akuker/RASCSI-68kmlaver/README.md

# RASCSI-68kmlaver
A scsi emulator based off of the work of http://www.geocities.jp/kugimoto0715/rascsi/index.html

# ATTENTION:
This repository is being archived. The current working version of the board has been moved to:
https://github.com/akuker/RASCSI/tree/master/hw/Dual_Connector_RaSCSI
