akuker/RASCSI-68kmlaver/design files/rpi_adapter/rpi_adapter/rpi_adapter.kicad_pcb

## KiCad design design files/rpi_adapter/rpi_adapter/rpi_adapter.kicad_pcb (2020-06-28)

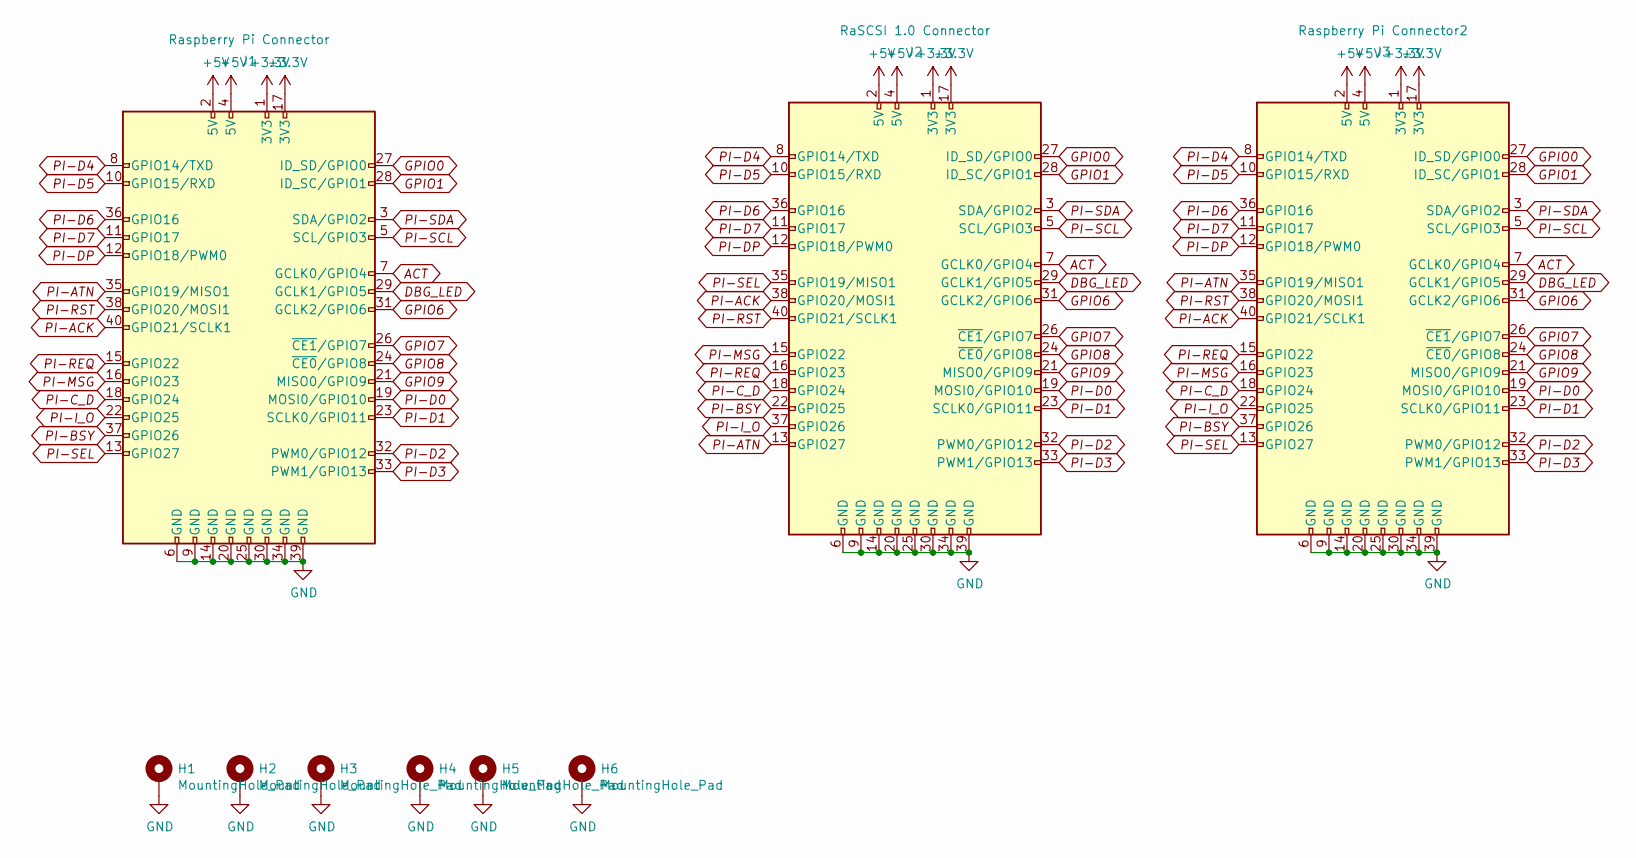
[picture p1: schematic rpi_adapter.sch]

Parts:
H1, H2, H3, H4, H5, H6: MountingHole_Pad; MountingHole_2.7mm_M2.5_Pad_Via
J1: Raspberry Pi Connector; PinHeader_2x20_P2.54mm_Vertical
J2: RaSCSI 1.0 Connector; PinHeader_2x20_P2.54mm_Vertical
J3: Raspberry Pi Connector2; PinHeader_2x20_P2.54mm_Vertical

Connections:
+3V3: J1.1 (3V3), J1.17 (3V3), J2.1 (3V3), J2.17 (3V3), J3.1 (3V3), J3.17 (3V3)
+5V: J1.2 (5V), J1.4 (5V), J2.2 (5V), J2.4 (5V), J3.2 (5V), J3.4 (5V)
ACT: J1.7 (GCLK0/GPIO4), J2.7 (GCLK0/GPIO4), J3.7 (GCLK0/GPIO4)
DBG_LED: J1.29 (GCLK1/GPIO5), J2.29 (GCLK1/GPIO5), J3.29 (GCLK1/GPIO5)
GND: H1.1, H2.1, H3.1, H4.1, H5.1, H6.1, J1.6 (GND), J1.9 (GND), J1.14 (GND), J1.20 (GND), J1.25 (GND), J1.30 (GND), J1.34 (GND), J1.39 (GND), J2.6 (GND), J2.9 (GND), J2.14 (GND), J2.20 (GND), J2.25 (GND), J2.30 (GND), J2.34 (GND), J2.39 (GND), J3.6 (GND), J3.9 (GND), J3.14 (GND), J3.20 (GND), J3.25 (GND), J3.30 (GND), J3.34 (GND), J3.39 (GND)
GPIO0: J1.27 (ID_SD/GPIO0), J2.27 (ID_SD/GPIO0), J3.27 (ID_SD/GPIO0)
GPIO1: J1.28 (ID_SC/GPIO1), J2.28 (ID_SC/GPIO1), J3.28 (ID_SC/GPIO1)
GPIO6: J1.31 (GCLK2/GPIO6), J2.31 (GCLK2/GPIO6), J3.31 (GCLK2/GPIO6)
GPIO7: J1.26 (~CE1~/GPIO7), J2.26 (~CE1~/GPIO7), J3.26 (~CE1~/GPIO7)
GPIO8: J1.24 (~CE0~/GPIO8), J2.24 (~CE0~/GPIO8), J3.24 (~CE0~/GPIO8)
GPIO9: J1.21 (MISO0/GPIO9), J2.21 (MISO0/GPIO9), J3.21 (MISO0/GPIO9)
PI-ACK: J1.40 (GPIO21/SCLK1), J2.38 (GPIO20/MOSI1), J3.40 (GPIO21/SCLK1)
PI-ATN: J1.35 (GPIO19/MISO1), J2.13 (GPIO27), J3.35 (GPIO19/MISO1)
PI-BSY: J1.37 (GPIO26), J2.22 (GPIO25), J3.37 (GPIO26)
PI-C_D: J1.18 (GPIO24), J2.18 (GPIO24), J3.18 (GPIO24)
PI-D0: J1.19 (MOSI0/GPIO10), J2.19 (MOSI0/GPIO10), J3.19 (MOSI0/GPIO10)
PI-D1: J1.23 (SCLK0/GPIO11), J2.23 (SCLK0/GPIO11), J3.23 (SCLK0/GPIO11)
PI-D2: J1.32 (PWM0/GPIO12), J2.32 (PWM0/GPIO12), J3.32 (PWM0/GPIO12)
PI-D3: J1.33 (PWM1/GPIO13), J2.33 (PWM1/GPIO13), J3.33 (PWM1/GPIO13)
PI-D4: J1.8 (GPIO14/TXD), J2.8 (GPIO14/TXD), J3.8 (GPIO14/TXD)
PI-D5: J1.10 (GPIO15/RXD), J2.10 (GPIO15/RXD), J3.10 (GPIO15/RXD)
PI-D6: J1.36 (GPIO16), J2.36 (GPIO16), J3.36 (GPIO16)
PI-D7: J1.11 (GPIO17), J2.11 (GPIO17), J3.11 (GPIO17)
PI-DP: J1.12 (GPIO18/PWM0), J2.12 (GPIO18/PWM0), J3.12 (GPIO18/PWM0)
PI-I_O: J1.22 (GPIO25), J2.37 (GPIO26), J3.22 (GPIO25)
PI-MSG: J1.16 (GPIO23), J2.15 (GPIO22), J3.16 (GPIO23)
PI-REQ: J1.15 (GPIO22), J2.16 (GPIO23), J3.15 (GPIO22)
PI-RST: J1.38 (GPIO20/MOSI1), J2.40 (GPIO21/SCLK1), J3.38 (GPIO20/MOSI1)
PI-SCL: J1.5 (SCL/GPIO3), J2.5 (SCL/GPIO3), J3.5 (SCL/GPIO3)
PI-SDA: J1.3 (SDA/GPIO2), J2.3 (SDA/GPIO2), J3.3 (SDA/GPIO2)
PI-SEL: J1.13 (GPIO27), J2.35 (GPIO19/MISO1), J3.13 (GPIO27)

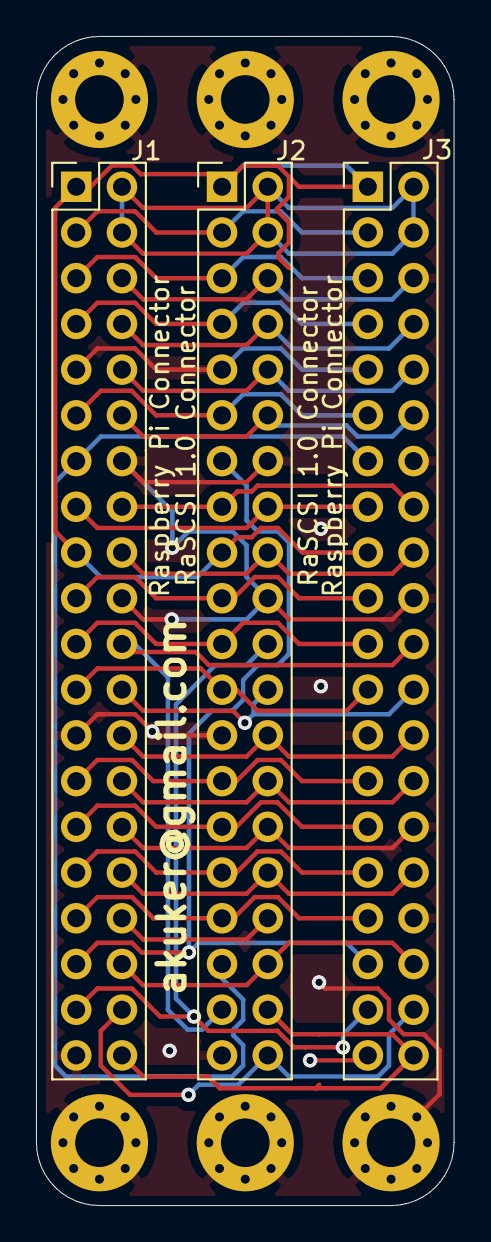
[picture p2: board rpi_adapter.kicad_pcb from above]

Board: 2 copper layers, 23.2 x 65.0 mm, 9 parts (0 on the bottom side), 31 nets.
