akuker/RASCSI-68kmlaver/design files/Dual Connector Ver/rascsi_din.kicad_pcb

## KiCad design design files/Dual Connector Ver/rascsi_din.kicad_pcb (2020-07-08)

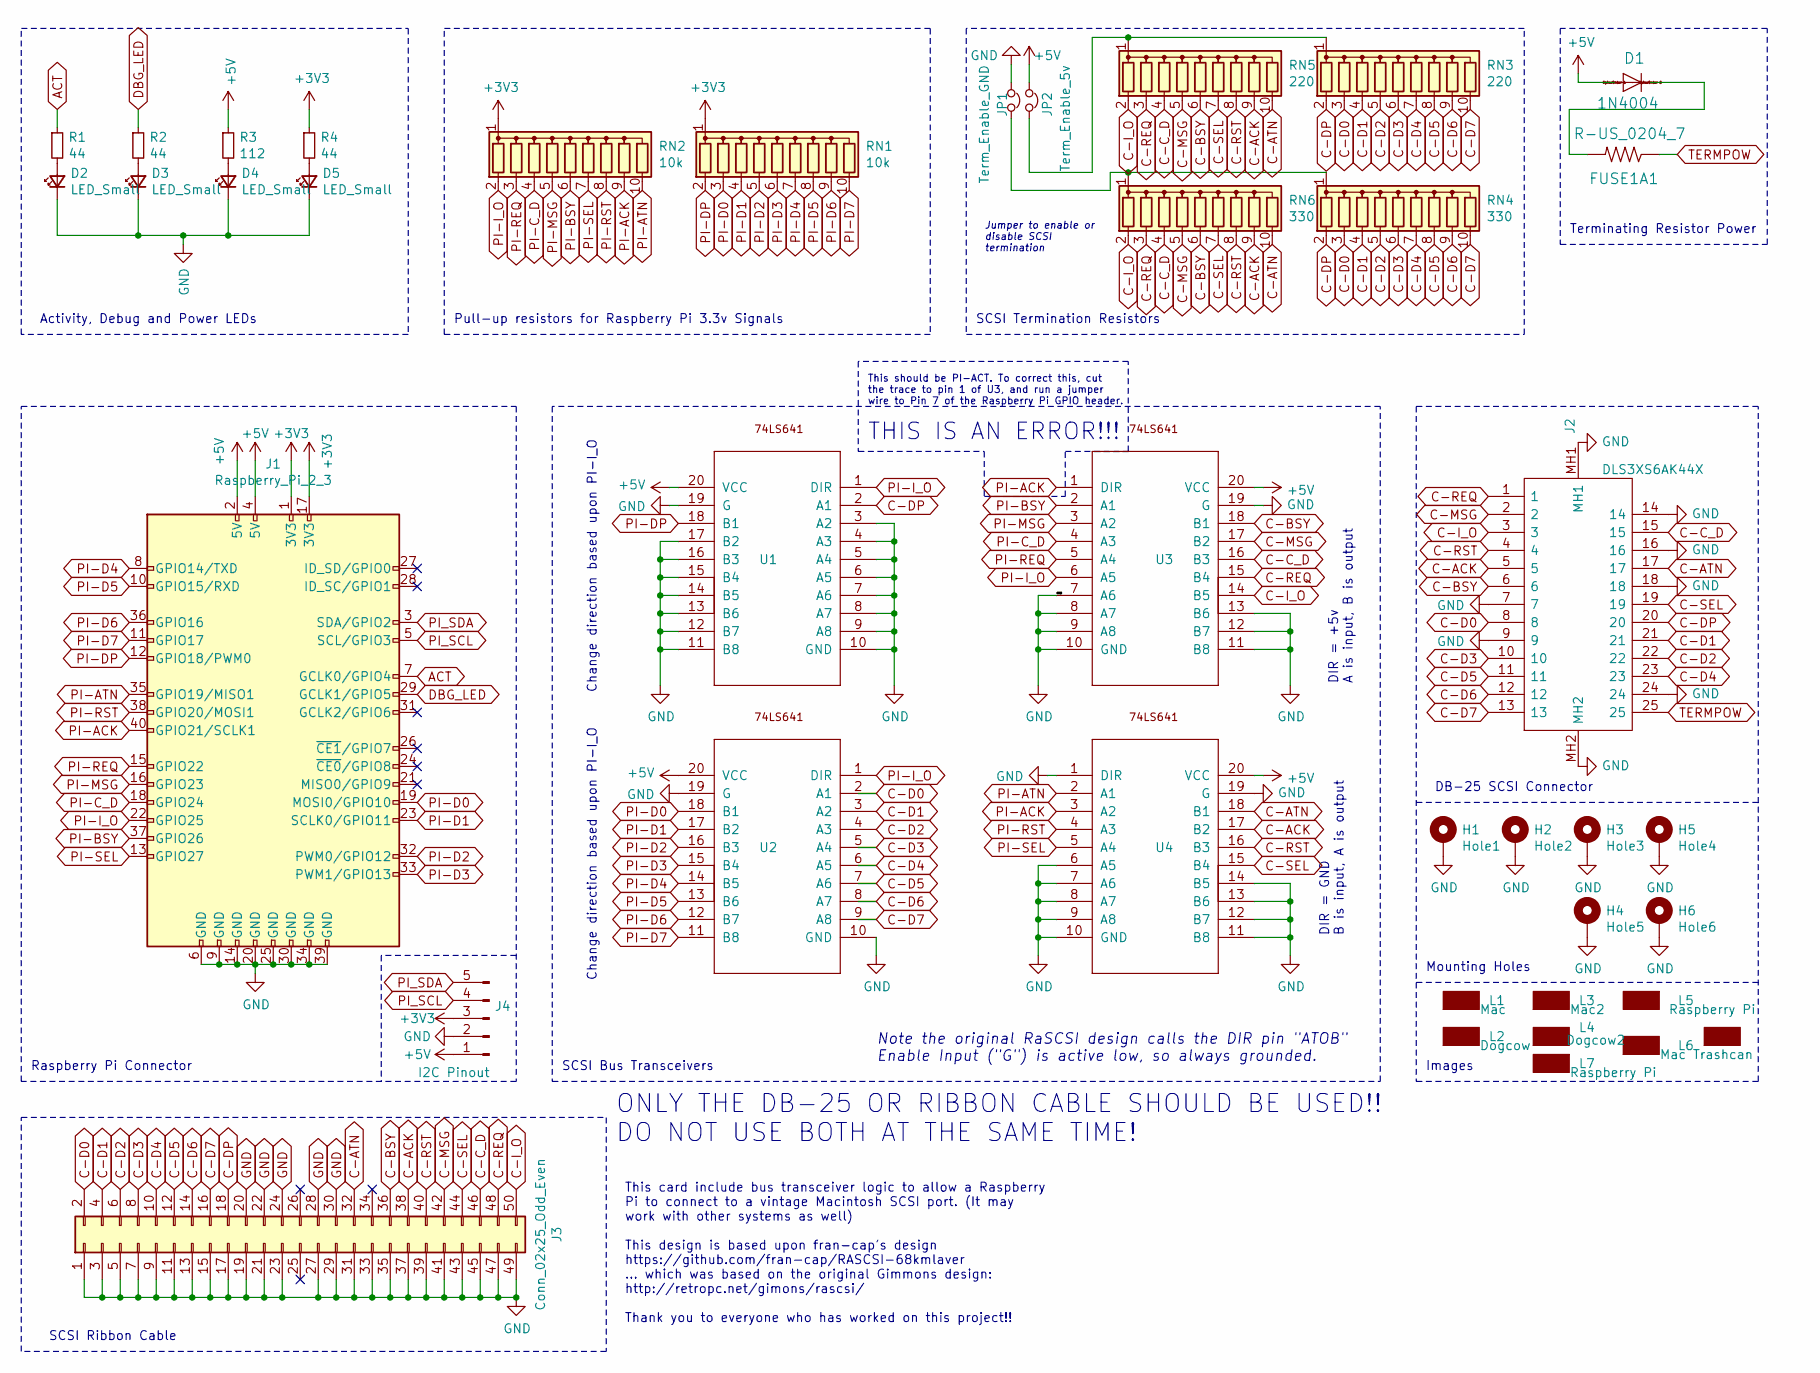
[picture p3: schematic rascsi_din.sch]

Parts:
D1: 1N4004; DO41-10
D2, D3, D4, D5: LED_Small; LED_0805_2012Metric
FUSE1A1: R-US_0204_7; 0204_7
H1: Hole1; MountingHole_2.7mm_M2.5_Pad_Via
H2: Hole2; MountingHole_2.7mm_M2.5_Pad_Via
H3: Hole3; MountingHole_2.7mm_M2.5_Pad_Via
H4: Hole5; MountingHole_2.7mm_M2.5_Pad_Via
H5: Hole4; MountingHole_2.7mm_M2.5_Pad_Via
H6: Hole6; MountingHole_2.7mm_M2.5_Pad_Via
J1: Raspberry_Pi_2_3; PinSocket_2x20_P2.54mm_Vertical
J2: DLS3XS6AK44X; Mouser Part Number 706-DLS3XS6AK44X
J3: Conn_02x25_Odd_Even; PinHeader_2x25_P2.54mm_Vertical_SMD
J4: I2C Pinout; PinSocket_1x05_P2.54mm_Vertical
JP1: Term_Enable_GND; PinSocket_1x02_P2.54mm_Vertical
JP2: Term_Enable_5v; PinSocket_1x02_P2.54mm_Vertical
L1: Mac; mac_happy_small
L2: Dogcow; dogcow
L3: Mac2; mac_happy_small
L4: Dogcow2; dogcow
L5, L7: Raspberry Pi; pi_logo
L6: Mac Trashcan; mac_trashcan
R1, R2, R4: 44; R_0805_2012Metric
R3: 112; R_0805_2012Metric
RN1, RN2: 10k; R_Array_SIP10
RN3, RN5: 220; R_Array_SIP10
RN4, RN6: 330; R_Array_SIP10
U1, U2, U3, U4: SN74LS641-1C; SOIC20S
U$1: LOGO

Connections:
+3V3: J1.1 (3V3), J1.17 (3V3), J4.3, R4.1, RN1.1 (common), RN2.1 (common)
+5V: D1.A, J1.2 (5V), J1.4 (5V), J4.1, JP2.1, R3.1, U1.20 (VCC), U2.20 (VCC), U3.20 (VCC), U4.20 (VCC)
ACT: J1.7 (GCLK0/GPIO4), R1.1
C-ACK: J2.5, J3.38, RN5.9 (R8), RN6.9 (R8), U4.17 (B2)
C-ATN: J2.17, J3.32, RN5.10 (R9), RN6.10 (R9), U4.18 (B1)
C-BSY: J2.6, J3.36, RN5.6 (R5), RN6.6 (R5), U3.18 (B1)
C-C_D: J2.15, J3.46, RN5.4 (R3), RN6.4 (R3), U3.16 (B3)
C-D0: J2.8, J3.2, RN3.3 (R2), RN4.3 (R2), U2.2 (A1)
C-D1: J2.21, J3.4, RN3.4 (R3), RN4.4 (R3), U2.3 (A2)
C-D2: J2.22, J3.6, RN3.5 (R4), RN4.5 (R4), U2.4 (A3)
C-D3: J2.10, J3.8, RN3.6 (R5), RN4.6 (R5), U2.5 (A4)
C-D4: J2.23, J3.10, RN3.7 (R6), RN4.7 (R6), U2.6 (A5)
C-D5: J2.11, J3.12, RN3.8 (R7), RN4.8 (R7), U2.7 (A6)
C-D6: J2.12, J3.14, RN3.9 (R8), RN4.9 (R8), U2.8 (A7)
C-D7: J2.13, J3.16, RN3.10 (R9), RN4.10 (R9), U2.9 (A8)
C-DP: J2.20, J3.18, RN3.2 (R1), RN4.2 (R1), U1.2 (A1)
C-I_O: J2.3, J3.50, RN5.2 (R1), RN6.2 (R1), U3.14 (B5)
C-MSG: J2.2, J3.42, RN5.5 (R4), RN6.5 (R4), U3.17 (B2)
C-REQ: J2.1, J3.48, RN5.3 (R2), RN6.3 (R2), U3.15 (B4)
C-RST: J2.4, J3.40, RN5.8 (R7), RN6.8 (R7), U4.16 (B3)
C-SEL: J2.19, J3.44, RN5.7 (R6), RN6.7 (R6), U4.15 (B4)
DBG_LED: J1.29 (GCLK1/GPIO5), R2.1
GND: D2.1 (K), D3.1 (K), D4.1 (K), D5.1 (K), H1.1, H2.1, H3.1, H4.1, H5.1, H6.1, J1.6 (GND), J1.9 (GND), J1.14 (GND), J1.20 (GND), J1.25 (GND), J1.30 (GND), J1.34 (GND), J1.39 (GND), J2.7, J2.9, J2.14, J2.16, J2.18, J2.24, J2.MH1, J2.MH2, J3.1, J3.3, J3.5, J3.7, J3.9, J3.11, J3.13, J3.15, J3.17, J3.19, J3.20, J3.21, J3.22, J3.23, J3.24, J3.27, J3.28, J3.29, J3.30, J3.31, J3.33, J3.35, J3.37, J3.39, J3.41, J3.43, J3.45, J3.47, J3.49, J4.2, JP1.1, U1.3 (A2), U1.4 (A3), U1.5 (A4), U1.6 (A5), U1.7 (A6), U1.8 (A7), U1.9 (A8), U1.10 (GND), U1.11 (B8), U1.12 (B7), U1.13 (B6), U1.14 (B5), U1.15 (B4), U1.16 (B3), U1.17 (B2), U1.19 (G), U2.10 (GND), U2.19 (G), U3.7 (A6), U3.8 (A7), U3.9 (A8), U3.10 (GND), U3.11 (B8), U3.12 (B7), U3.13 (B6), U3.19 (G), U4.1 (DIR), U4.6 (A5), U4.7 (A6), U4.8 (A7), U4.9 (A8), U4.10 (GND), U4.11 (B8), U4.12 (B7), U4.13 (B6), U4.14 (B5), U4.19 (G)
unnamed: D1.C, FUSE1A1.2
unnamed: D2.2 (A), R1.2
unnamed: D3.2 (A), R2.2
unnamed: D4.2 (A), R3.2
unnamed: D5.2 (A), R4.2
unnamed: JP1.2, RN4.1 (common), RN6.1 (common)
unnamed: JP2.2, RN3.1 (common), RN5.1 (common)
PI-ACK: J1.40 (GPIO21/SCLK1), RN2.9 (R8), U3.1 (DIR), U4.3 (A2)
PI-ATN: J1.35 (GPIO19/MISO1), RN2.10 (R9), U4.2 (A1)
PI-BSY: J1.37 (GPIO26), RN2.6 (R5), U3.2 (A1)
PI-C_D: J1.18 (GPIO24), RN2.4 (R3), U3.4 (A3)
PI-D0: J1.19 (MOSI0/GPIO10), RN1.3 (R2), U2.18 (B1)
PI-D1: J1.23 (SCLK0/GPIO11), RN1.4 (R3), U2.17 (B2)
PI-D2: J1.32 (PWM0/GPIO12), RN1.5 (R4), U2.16 (B3)
PI-D3: J1.33 (PWM1/GPIO13), RN1.6 (R5), U2.15 (B4)
PI-D4: J1.8 (GPIO14/TXD), RN1.7 (R6), U2.14 (B5)
PI-D5: J1.10 (GPIO15/RXD), RN1.8 (R7), U2.13 (B6)
PI-D6: J1.36 (GPIO16), RN1.9 (R8), U2.12 (B7)
PI-D7: J1.11 (GPIO17), RN1.10 (R9), U2.11 (B8)
PI-DP: J1.12 (GPIO18/PWM0), RN1.2 (R1), U1.18 (B1)
PI-I_O: J1.22 (GPIO25), RN2.2 (R1), U1.1 (DIR), U2.1 (DIR), U3.6 (A5)
PI-MSG: J1.16 (GPIO23), RN2.5 (R4), U3.3 (A2)
PI-REQ: J1.15 (GPIO22), RN2.3 (R2), U3.5 (A4)
PI-RST: J1.38 (GPIO20/MOSI1), RN2.8 (R7), U4.4 (A3)
PI-SEL: J1.13 (GPIO27), RN2.7 (R6), U4.5 (A4)
PI_SCL: J1.5 (SCL/GPIO3), J4.4
PI_SDA: J1.3 (SDA/GPIO2), J4.5
TERMPOW: FUSE1A1.1, J2.25

Notes on the sheet:
Note the original RaSCSI design calls the DIR pin "ATOB" Enable Input ("G") is active low, so always grounded.
Activity, Debug and Power LEDs
Pull-up resistors for Raspberry Pi 3.3v Signals
SCSI Termination Resistors
Raspberry Pi Connector
Terminating Resistor Power
SCSI Bus Transceivers
Change direction based upon PI-I_O
DIR = GND B is input, A is output
DIR = +5v A is input, B is output
DB-25 SCSI Connector
SCSI Ribbon Cable
ONLY THE DB-25 OR RIBBON CABLE SHOULD BE USED!! DO NOT USE BOTH AT THE SAME TIME!
This card include bus transceiver logic to allow a Raspberry Pi to connect to a vintage Macintosh SCSI port. (It may work with other systems as well) This design is based upon fran-cap's design https://github.com/fran-cap/RASCSI-68kmlaver ... which was based on the original Gimmons design: http://r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
Images
Mounting Holes
Jumper to enable or disable SCSI termination
THIS IS AN ERROR!!!
This should be PI-ACT. To correct this, cut the trace to pin 1 of U3, and run a jumper wire to Pin 7 of the Raspberry Pi GPIO header.

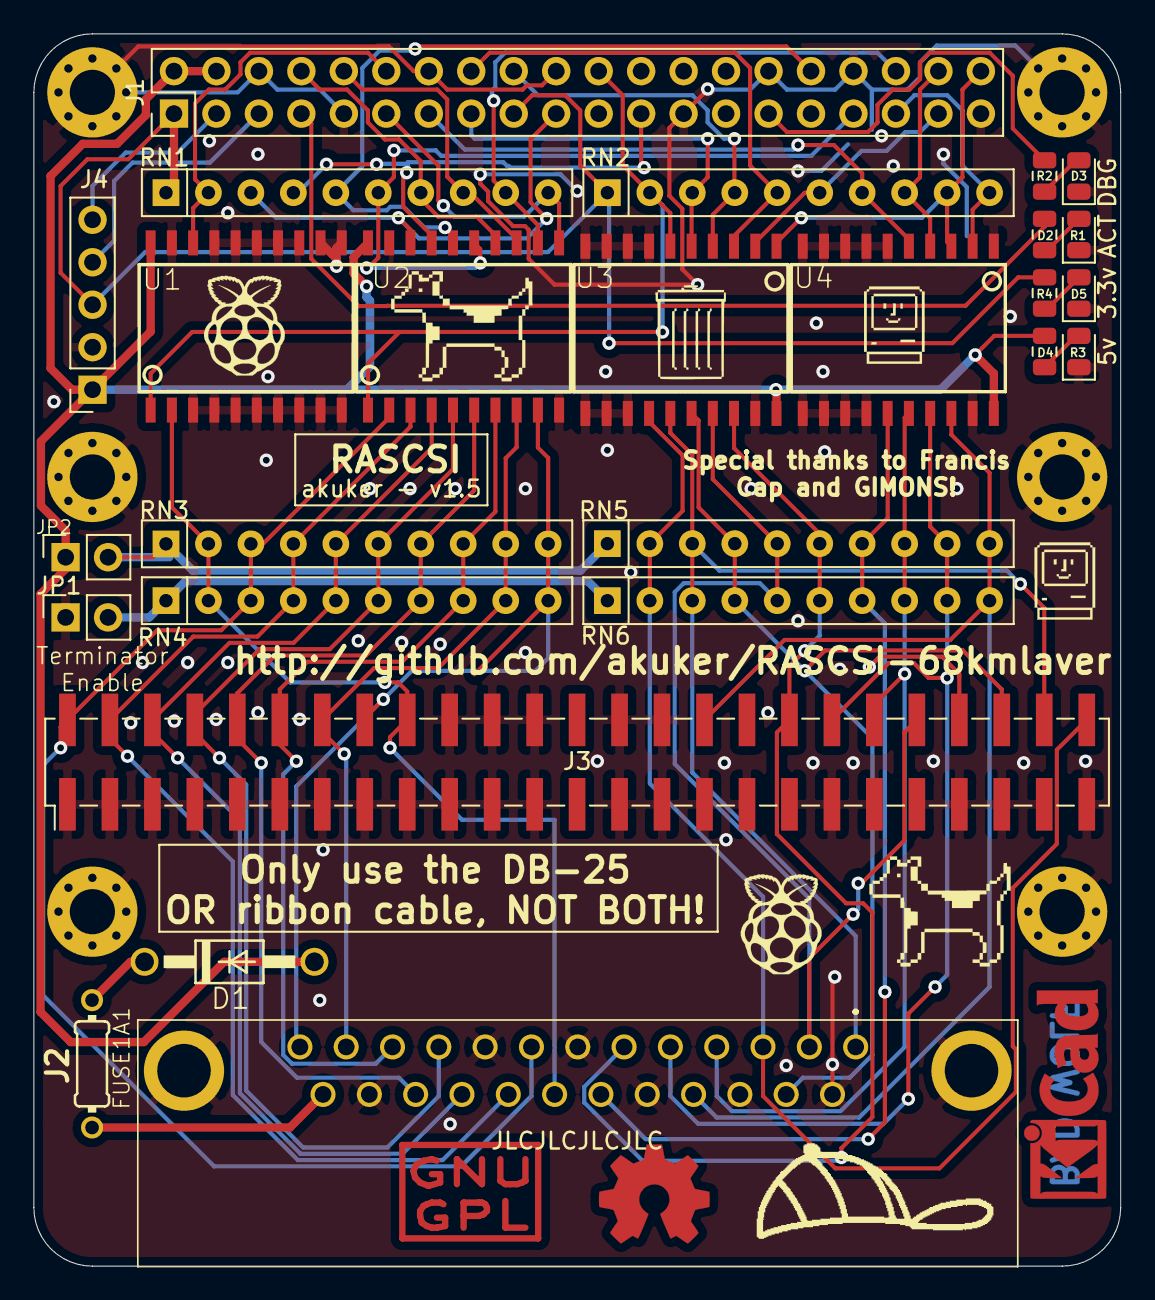
[picture p4: board rascsi_din.kicad_pcb from above]

Board: 2 copper layers, 65.0 x 73.7 mm, 40 parts (0 on the bottom side), 51 nets.
