akuker/RASCSI-68kmlaver/design files/Ribbon50 Ver/rascsi-right.brd

## EAGLE design design files/Ribbon50 Ver/rascsi-right.brd (2020-06-26)

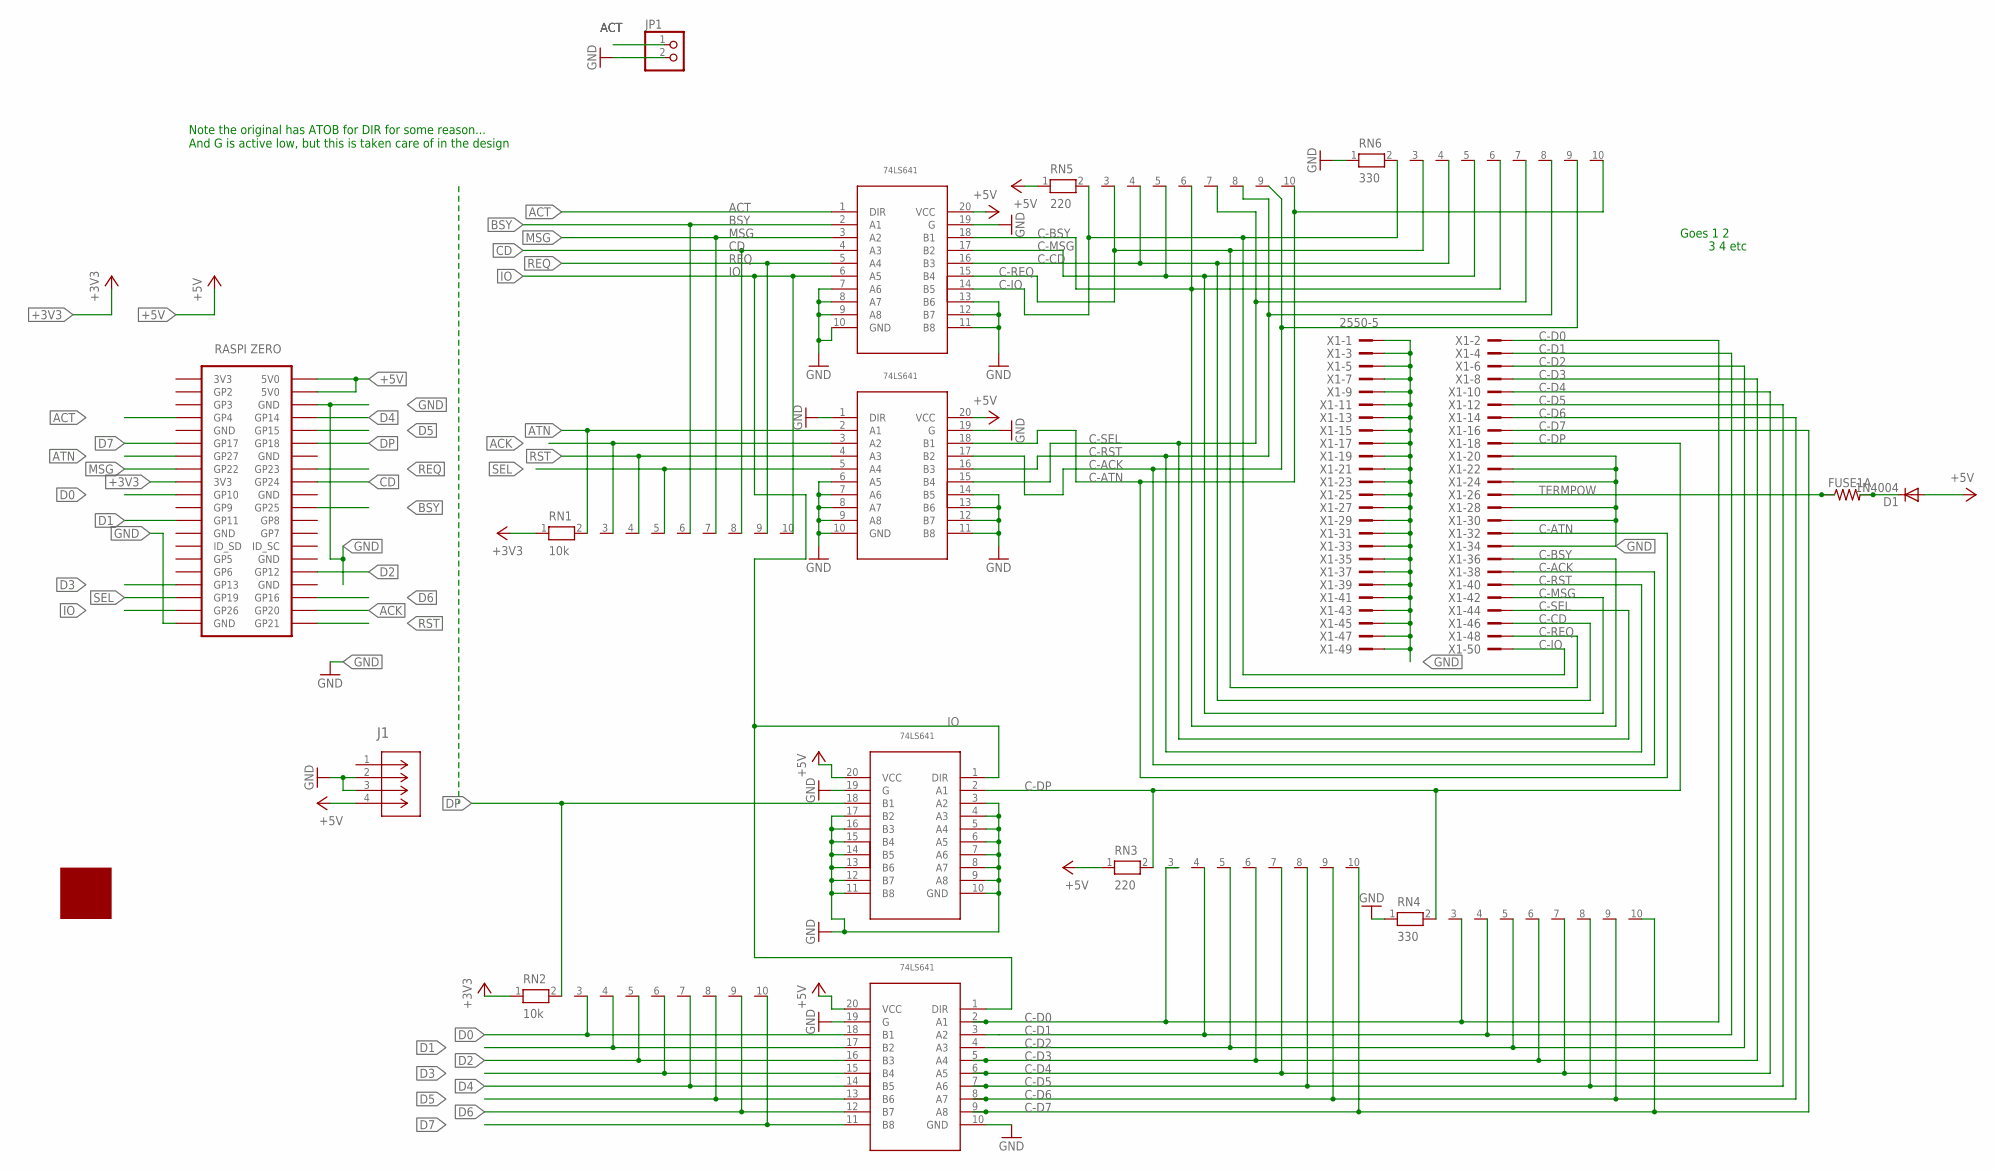
[picture p5: schematic rascsi-right.sch]

Parts:
D1: 1N4004; DO41-10
FUSE1A: R-US_0204/7; 0204/7
J1: 171826-4; CONN_171826-4_TYCO
JP1: PINHD-1X2; 1X02
RN1, RN2: 10k; RN-10
RN3, RN5: 220; RN-10
RN4, RN6: 330; RN-10
U11, U22, U33, U44: SN74LS641-1SC; SOIC20S
U$1: ZERO
U$2: LOGO
X1: 2550-5; PAK100/2500-5-50

Connections:
+3V3: RN1.1, RN2.1, U$1.17 (3V3)
+5V: D1.A, J1.4, RN3.1, RN5.1, U11.20 (VCC), U22.20 (VCC), U33.20 (VCC), U44.20 (VCC), U$1.2 (5V0), U$1.4 (5V0)
ACK: RN1.3, U22.3 (A2), U$1.38 (GP20)
ACT: JP1.1, U11.1 (DIR), U$1.7 (GP4)
ATN: RN1.2, U22.2 (A1), U$1.13 (GP27)
BSY: RN1.6, U11.2 (A1), U$1.22 (GP25)
C-ACK: RN5.9, RN6.9, U22.17 (B2), X1.38
C-ATN: RN5.10, RN6.10, U22.18 (B1), X1.32
C-BSY: RN5.6, RN6.6, U11.18 (B1), X1.36
C-CD: RN5.4, RN6.4, U11.16 (B3), X1.46
C-D0: RN3.3, RN4.3, U44.2 (A1), X1.2
C-D1: RN3.4, RN4.4, U44.3 (A2), X1.4
C-D2: RN3.5, RN4.5, U44.4 (A3), X1.6
C-D3: RN3.6, RN4.6, U44.5 (A4), X1.8
C-D4: RN3.7, RN4.7, U44.6 (A5), X1.10
C-D5: RN3.8, RN4.8, U44.7 (A6), X1.12
C-D6: RN3.9, RN4.9, U44.8 (A7), X1.14
C-D7: RN3.10, RN4.10, U44.9 (A8), X1.16
C-DP: RN3.2, RN4.2, U33.2 (A1), X1.18
C-IO: RN5.2, RN6.2, U11.14 (B5), X1.50
C-MSG: RN5.5, RN6.5, U11.17 (B2), X1.42
C-REQ: RN5.3, RN6.3, U11.15 (B4), X1.48
C-RST: RN5.8, RN6.8, U22.16 (B3), X1.40
C-SEL: RN5.7, RN6.7, U22.15 (B4), X1.44
CD: RN1.8, U11.4 (A3), U$1.18 (GP24)
D0: RN2.3, U44.18 (B1), U$1.19 (GP10)
D1: RN2.4, U44.17 (B2), U$1.23 (GP11)
D2: RN2.5, U44.16 (B3), U$1.32 (GP12)
D3: RN2.6, U44.15 (B4), U$1.33 (GP13)
D4: RN2.7, U44.14 (B5), U$1.8 (GP14)
D5: RN2.8, U44.13 (B6), U$1.10 (GP15)
D6: RN2.9, U44.12 (B7), U$1.36 (GP16)
D7: RN2.10, U44.11 (B8), U$1.11 (GP17)
DP: RN2.2, U33.18 (B1), U$1.12 (GP18)
GND: J1.2, J1.3, JP1.2, RN4.1, RN6.1, U11.7 (A6), U11.8 (A7), U11.9 (A8), U11.10 (GND), U11.11 (B8), U11.12 (B7), U11.13 (B6), U11.19 (G), U22.1 (DIR), U22.6 (A5), U22.7 (A6), U22.8 (A7), U22.9 (A8), U22.10 (GND), U22.11 (B8), U22.12 (B7), U22.13 (B6), U22.14 (B5), U22.19 (G), U33.3 (A2), U33.4 (A3), U33.5 (A4), U33.6 (A5), U33.7 (A6), U33.8 (A7), U33.9 (A8), U33.10 (GND), U33.11 (B8), U33.12 (B7), U33.13 (B6), U33.14 (B5), U33.15 (B4), U33.16 (B3), U33.17 (B2), U33.19 (G), U44.10 (GND), U44.19 (G), U$1.6 (GND), U$1.39 (GND), X1.1, X1.3, X1.5, X1.7, X1.9, X1.11, X1.13, X1.15, X1.17, X1.19, X1.20, X1.21, X1.22, X1.23, X1.24, X1.25, X1.27, X1.28, X1.29, X1.30, X1.31, X1.33, X1.34, X1.35, X1.37, X1.39, X1.41, X1.43, X1.45, X1.47, X1.49
IO: RN1.10, U11.6 (A5), U33.1 (DIR), U44.1 (DIR), U$1.37 (GP26)
MSG: RN1.7, U11.3 (A2), U$1.15 (GP22)
unnamed: D1.C, FUSE1A.2
REQ: RN1.9, U11.5 (A4), U$1.16 (GP23)
RST: RN1.4, U22.4 (A3), U$1.40 (GP21)
SEL: RN1.5, U22.5 (A4), U$1.35 (GP19)
TERMPOW: FUSE1A.1, X1.26

Notes on the sheet:
Note the original has ATOB for DIR for some reason... And G is active low, but this is taken care of in the design
Goes 1 2
3 4 etc

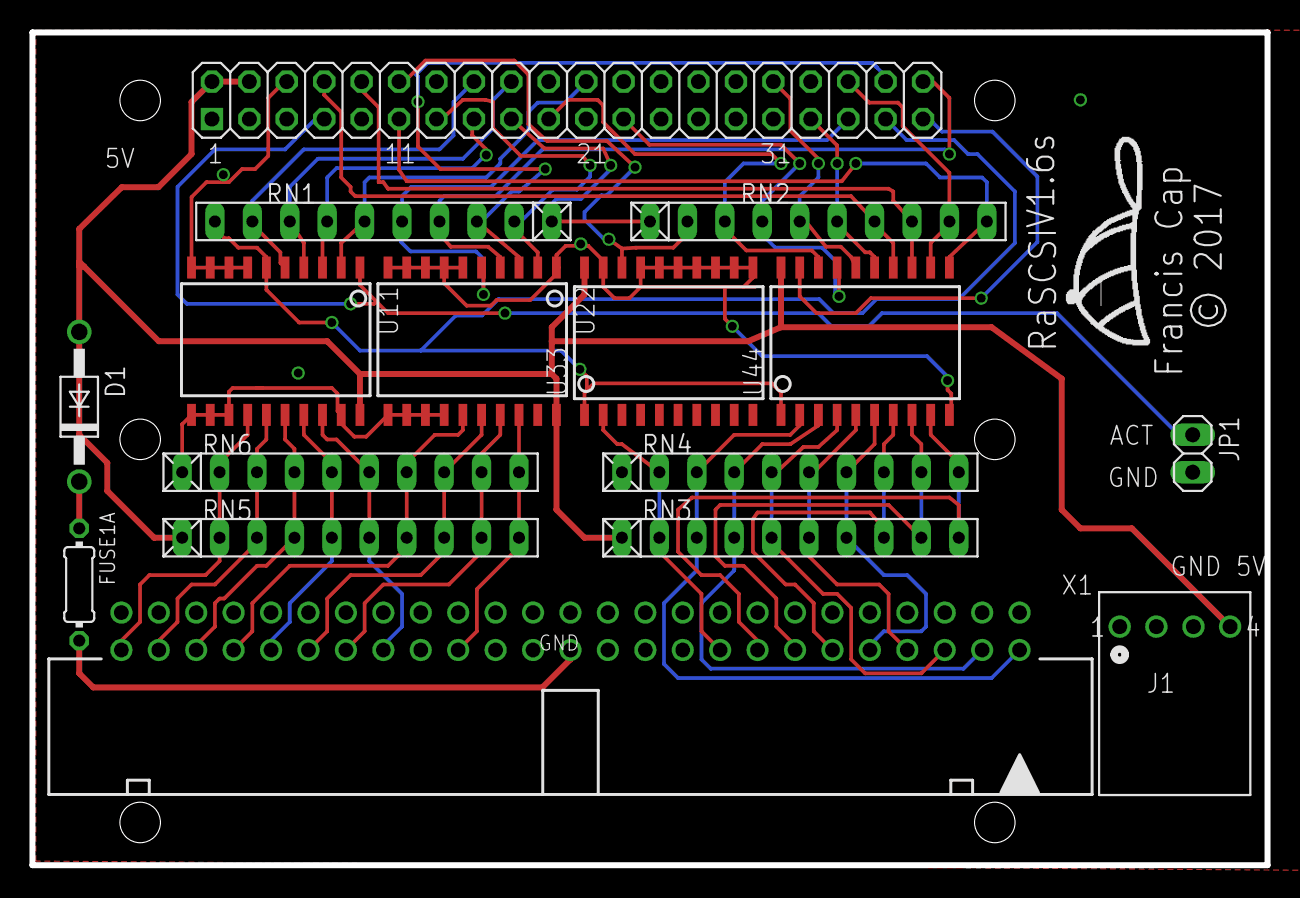
[picture p6: board rascsi-right.brd from above]

Board: 2 copper layers, 83.8 x 56.5 mm, 17 parts (0 on the bottom side), 42 nets.
