akuker/RASCSI-68kmlaver/(commit log)

2020-06-26 Moved 50-pin Ribbon version of the board into a directory Added a dual-connector version of the board. (New board is in KiCad, not Eagle)
    [rascsi-right.brd, rascsi-right.sch, rascsi_din.kicad_pcb, rascsi_din.sch]
2020-06-26 Add silk screen art and clean up labels
    [rascsi_din.kicad_pcb]
2020-06-27 Cleanup and created BOM and Gerber files
    [rascsi_din-B_Mask.gbr, rascsi_din-B_Paste.gbr, rascsi_din-B_SilkS.gbr, rascsi_din-Bottom.gbr, rascsi_din-Edge_Cuts.gbr, rascsi_din-F_Mask.gbr, rascsi_din-F_Paste.gbr, rascsi_din-F_SilkS.gbr]
2020-06-28 Created adapter to correct pin layout on version 1.0. Also created version 1.5 which corrects the connections
    [rascsi_din-job.gbrjob, rascsi_din.drl, rpi_adapter-B_Cu.gbr, rpi_adapter-B_Mask.gbr, rpi_adapter-B_Paste.gbr, rpi_adapter-B_SilkS.gbr, rpi_adapter-Edge_Cuts.gbr, rpi_adapter-F_Cu.gbr]
2020-06-28 Corrected pinout to match original RaSCSI design.
    [rascsi_din-B_Mask.gbr, rascsi_din-B_Paste.gbr, rascsi_din-B_SilkS.gbr, rascsi_din-Bottom.gbr, rascsi_din-Edge_Cuts.gbr, rascsi_din-F_Mask.gbr, rascsi_din-F_Paste.gbr, rascsi_din-F_SilkS.gbr]
2020-07-08 Restored the correct version of the schematic & added notes to fix the PI-ACT signal. Also adding the gerber files.
    [rascsi_din.kicad_pcb, rascsi_din.sch]
