akuker/RASCSI-68kmlaver/(notices)

Notices in the files:
design files/Ribbon50 Ver/rascsi-right.brd:
© 2017
